DefaultHahn/Nebeltopf/bilder/d_kabel.png

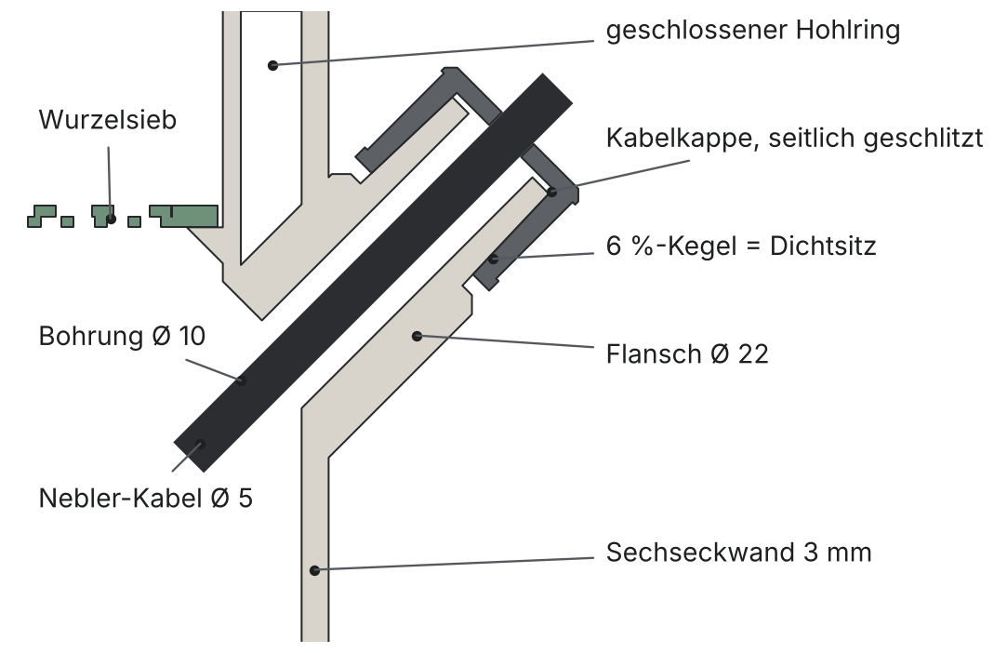
bilder/d_kabel.png
