DefaultHahn/Nebeltopf/stl/sockel.stl

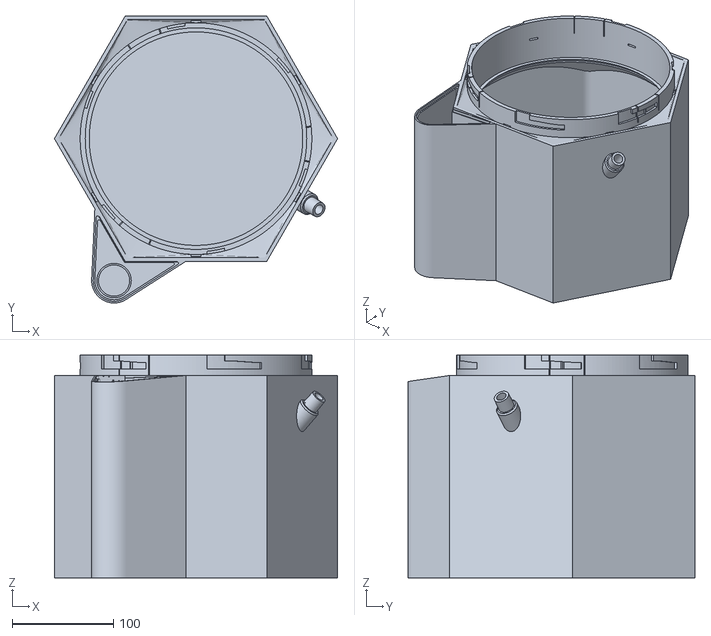
[picture p37: CAD file, 2026-10-07]
stl/sockel.stl
280.0 x 283.7 x 220.0
