DefaultHahn/Nebeltopf/stl/kammerdeckel.stl

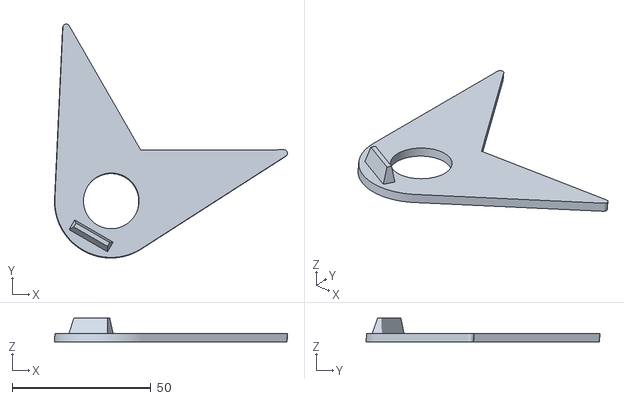
[picture p38: CAD file, 2026-10-06]
stl/kammerdeckel.stl
83.9 x 84.3 x 8.56
