DefaultHahn/Nebeltopf/stl/podest.stl

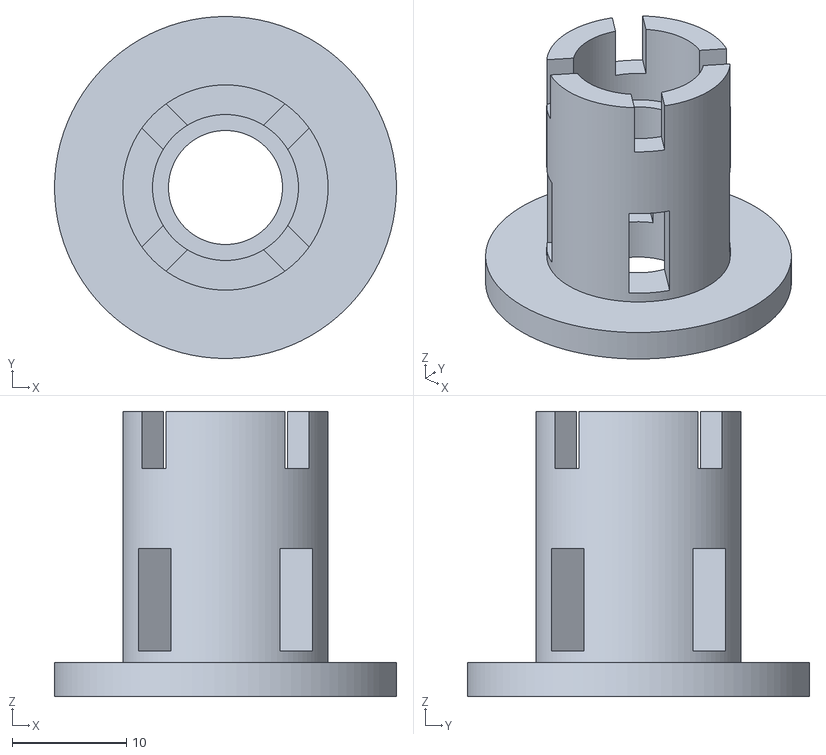
[picture p39: CAD file, 2026-10-06]
stl/podest.stl
30.0 x 30.0 x 25.0
