DefaultHahn/Nebeltopf/stl/pruefblock.stl

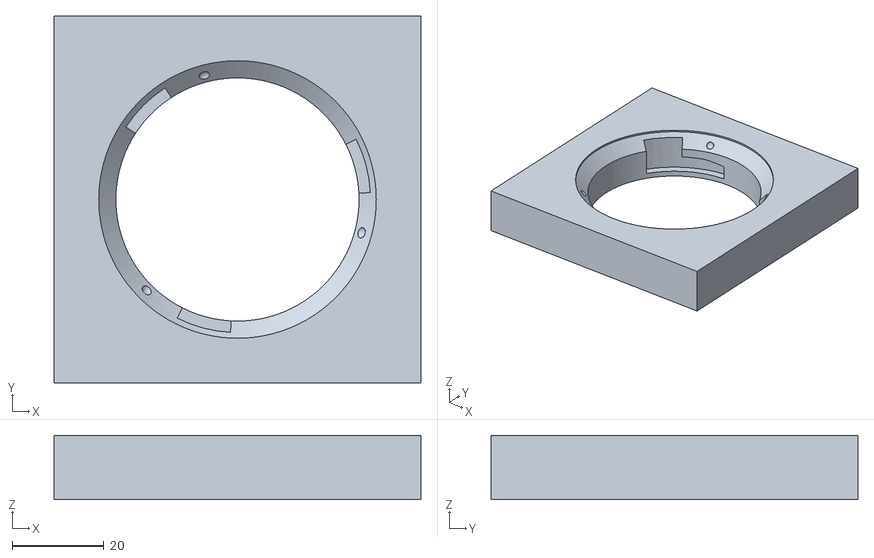
[picture p40: CAD file, 2026-10-06]
stl/pruefblock.stl
80.0 x 80.0 x 14.0
