DefaultHahn/Nebeltopf/stl/kuppel_farbe2.stl

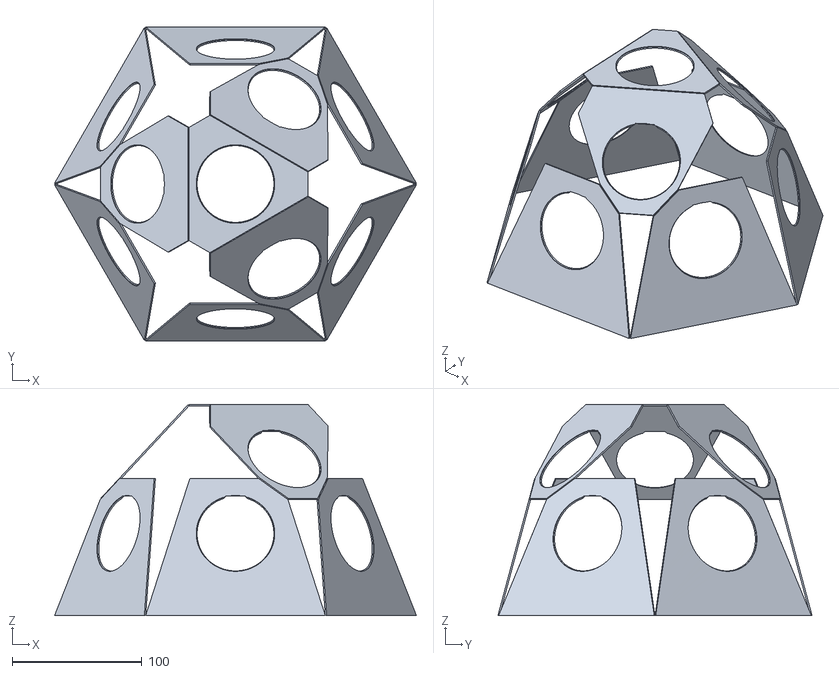
[picture p41: CAD file, 2026-10-06]
stl/kuppel_farbe2.stl
279.0 x 242.2 x 162.9
