DefaultHahn/Nebeltopf/stl/kragenadapter.stl

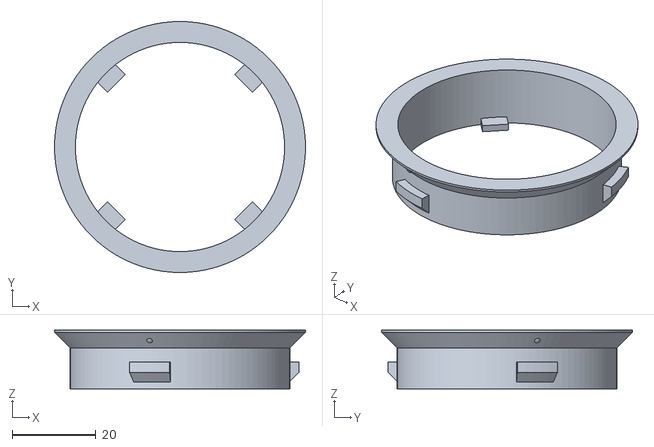
[picture p42: CAD file, 2026-10-06]
stl/kragenadapter.stl
60.0 x 60.0 x 14.0
