DefaultHahn/Nebeltopf/stl/kabelkappe.stl

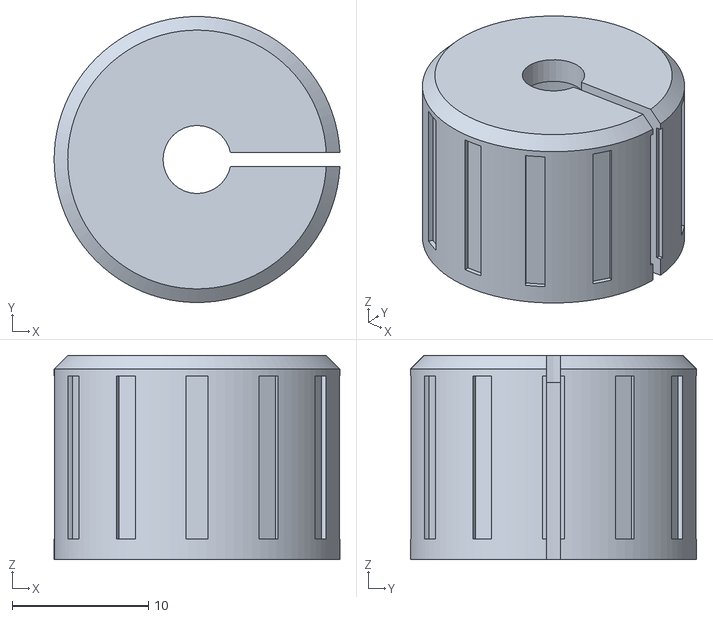
[picture p43: CAD file, 2026-10-06]
stl/kabelkappe.stl
21.0 x 21.0 x 15.0
