DefaultHahn/Nebeltopf/stl/sieb.stl

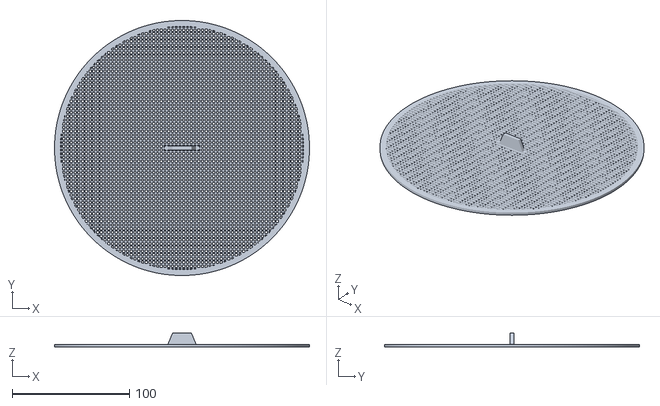
[picture p44: CAD file, 2026-10-06]
stl/sieb.stl
217.8 x 217.8 x 12.1
