DefaultHahn/Nebeltopf/stl/kuppel.stl

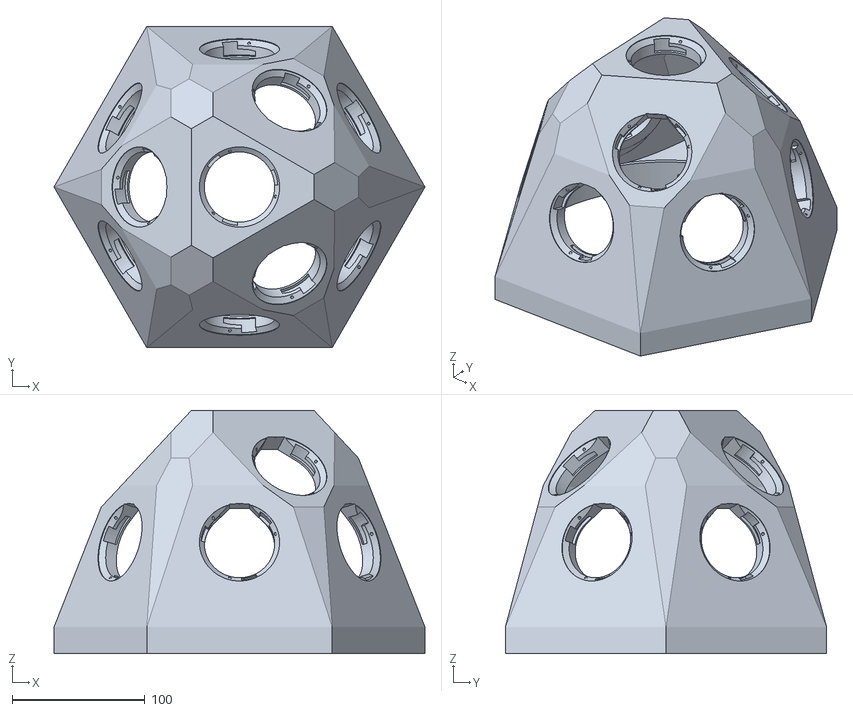
[picture p45: CAD file, 2026-10-06]
stl/kuppel.stl
280.0 x 242.5 x 183.5
