DefaultHahn/Nebeltopf/stl/netztopf.stl

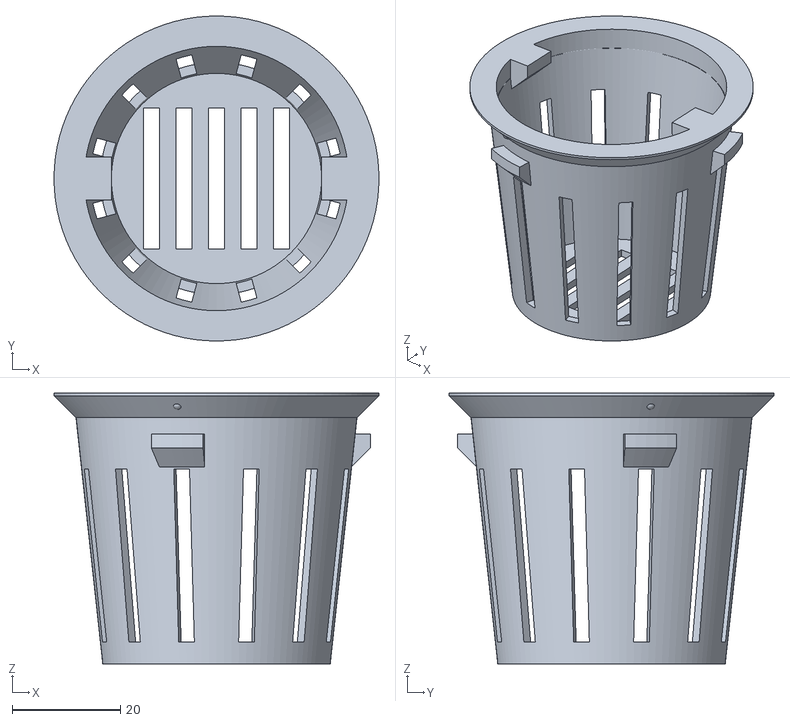
[picture p46: CAD file, 2026-10-06]
stl/netztopf.stl
60.0 x 60.0 x 50.0
