DefaultHahn/Nebeltopf/stl/kuppel_haupt.stl

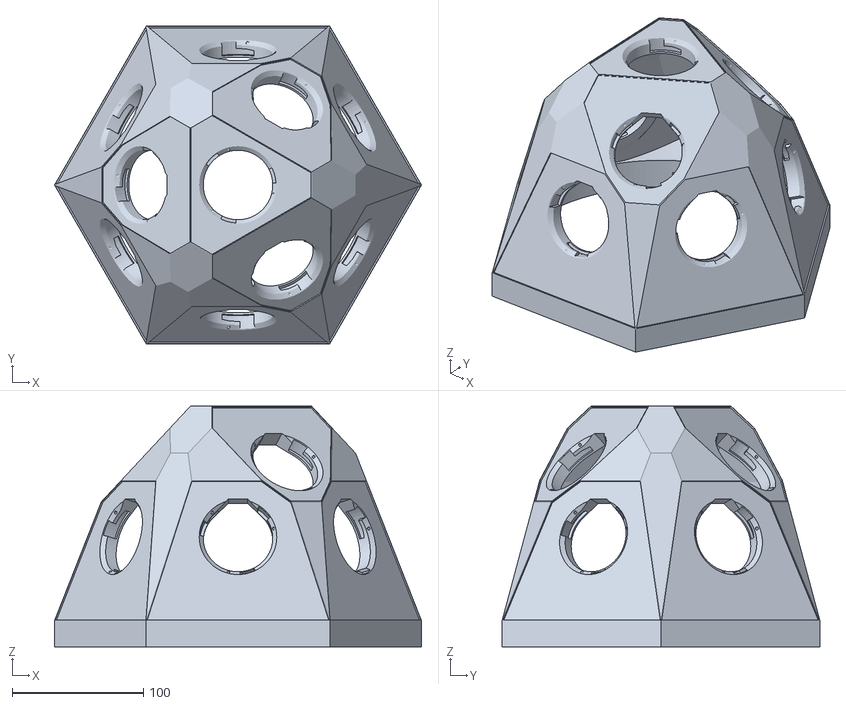
[picture p47: CAD file, 2026-10-06]
stl/kuppel_haupt.stl
280.0 x 242.5 x 183.5
