DefaultHahn/Nebeltopf/(list of files, cad)

Other CAD files:
stl/blindkappe.stl
