DefaultHahn/Nebeltopf/(commit log)

2026-10-06 Nebeltopf v5: Fogponik-Pflanzturm für den Bambu Lab H2D
    Parametrisches OpenSCAD-Modell, alle STL in Druckrichtung, Anleitung,
    Konstruktionsbeschreibung (PDF) und Bilder.
    Claude-Session: https://claude.ai/code/session_01SJQafHCWinepnzeN7TenZw
    [blindkappe.stl, kabelkappe.stl, kammerdeckel.stl, kragenadapter.stl, kuppel.stl, kuppel_farbe2.stl, kuppel_haupt.stl, nebeltopf.scad]
2026-10-07 Nebeltopf v6: Sechseck als Tank, ohne runde Innenwand
    - Sechseckwand 3 mm ist jetzt die Tankwand, Innenecken mit 10 mm gerundet
    - 45°-Übergang vom Sechseck auf den runden Kragen, darüber ein geschlossener Hohlring
    - Durchlass zur Wasserkammer direkt durch die Ecke
    - Sockel ca. 1,3 kg statt 1,65 kg, Wasser bis MAX 6,6 l statt 5,2 l
    - Druckprofile für Bambu Studio (Sockel wasserdicht, SUNLU PETG H2D)
    - Dokumentation, Anleitung und Bilder auf v6
    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
    [nebeltopf.scad, sockel.stl]
